listeven/SWEET/finalCode/SmartGrid/graphics/linescomplicated.png

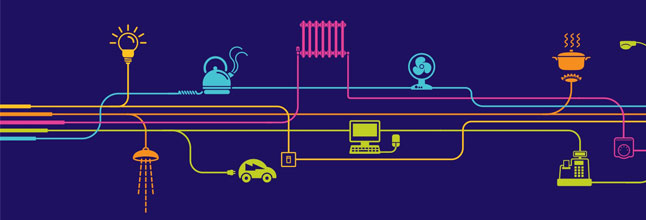
finalCode/SmartGrid/graphics/linescomplicated.png
