listeven/SWEET/Circuit PDF and CAM files/SchematicsPDF.pdf

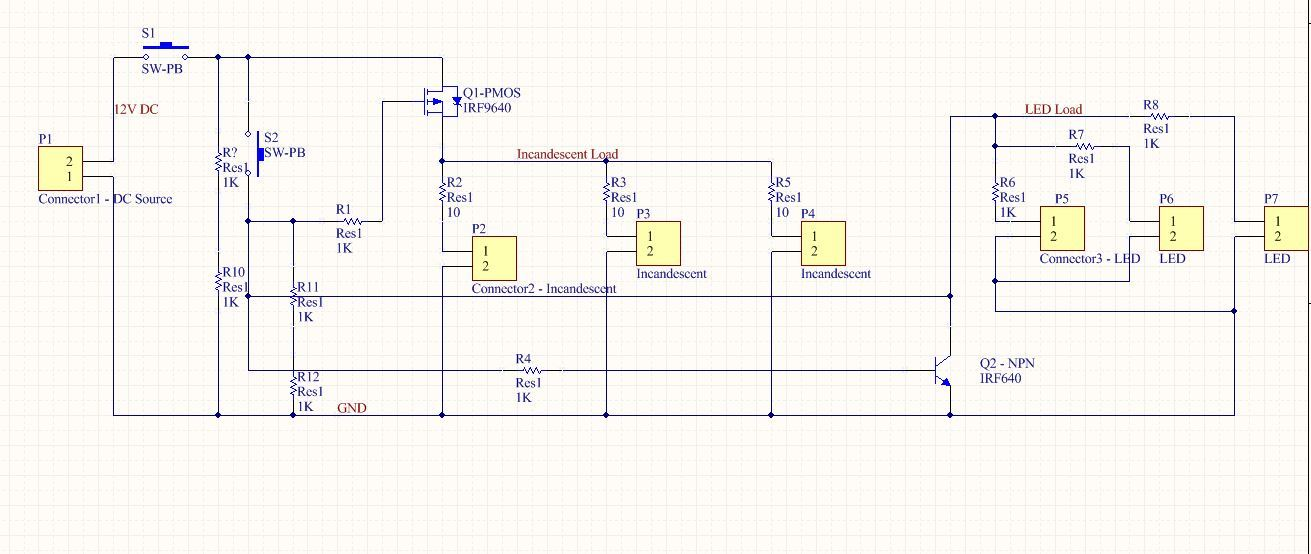
[picture p8: figure]

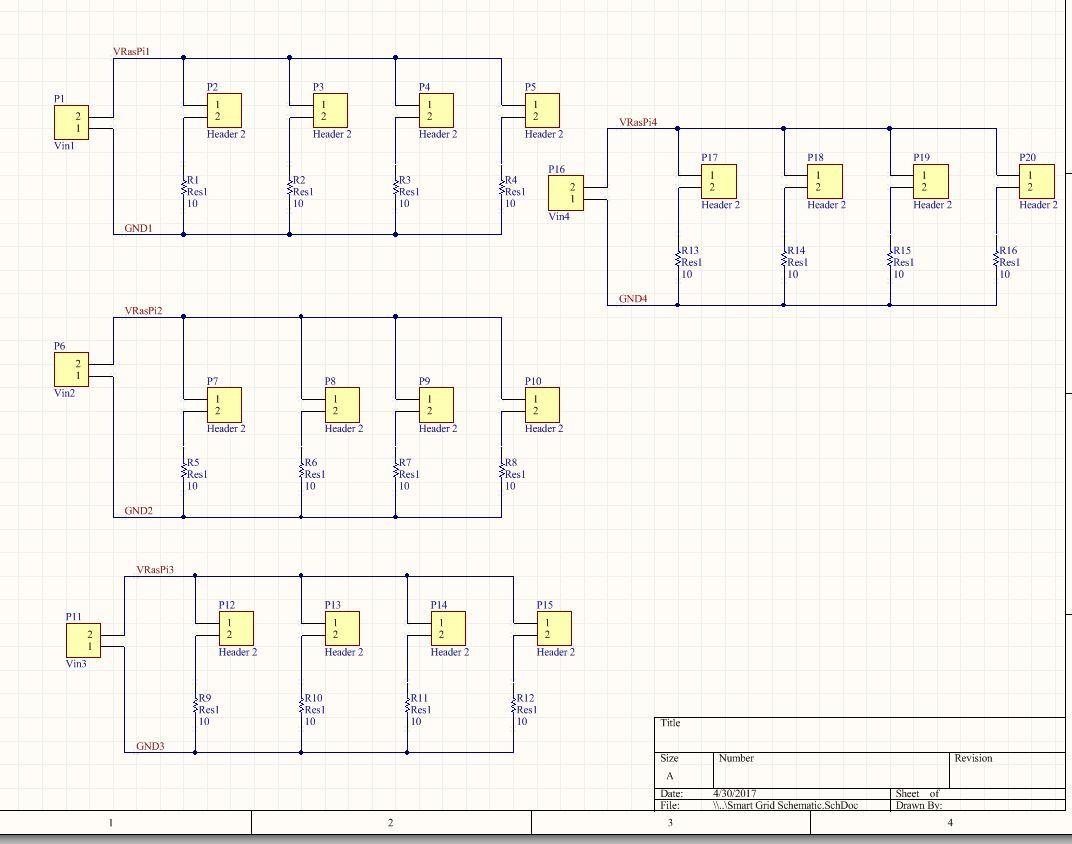
[picture p9: figure]

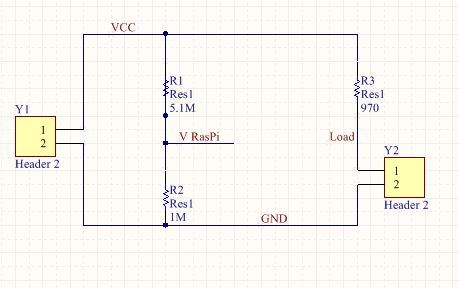
[picture p10: figure]
