listeven/SWEET/Circuit PDF and CAM files/Wind Schematic.pdf

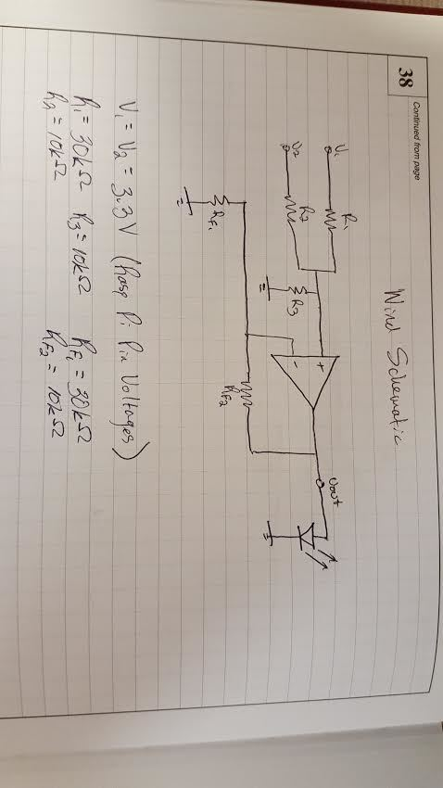
[picture p11: figure]
