listeven/SWEET/finalCode/SmartGrid/graphics/10Percent.png

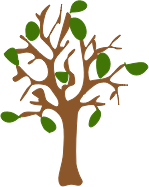
finalCode/SmartGrid/graphics/10Percent.png
