listeven/SWEET/finalCode/SmartGrid/graphics/20Percent.png

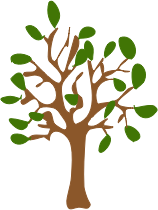
finalCode/SmartGrid/graphics/20Percent.png
