listeven/SWEET/finalCode/SmartGrid/graphics/30Percent.png

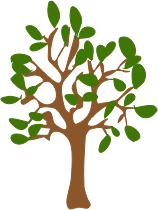
finalCode/SmartGrid/graphics/30Percent.png
