listeven/SWEET/finalCode/SmartGrid/graphics/40Percent.png

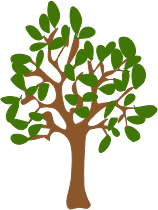
finalCode/SmartGrid/graphics/40Percent.png
