listeven/SWEET/finalCode/SmartGrid/graphics/50Percent.png

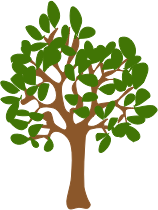
finalCode/SmartGrid/graphics/50Percent.png
