listeven/SWEET/finalCode/SmartGrid/graphics/70percent.png

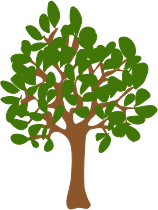
finalCode/SmartGrid/graphics/70percent.png
