listeven/SWEET/finalCode/SmartGrid/graphics/80percent.png

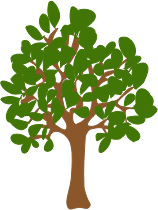
finalCode/SmartGrid/graphics/80percent.png
