listeven/SWEET/finalCode/SmartGrid/graphics/90percent.png

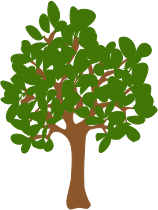
finalCode/SmartGrid/graphics/90percent.png
