listeven/SWEET/finalCode/SmartGrid/graphics/100percent.png

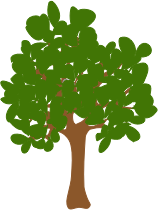
finalCode/SmartGrid/graphics/100percent.png
