listeven/SWEET/finalCode/SmartGrid/graphics/Blog_Gados_NatGrid.jpg

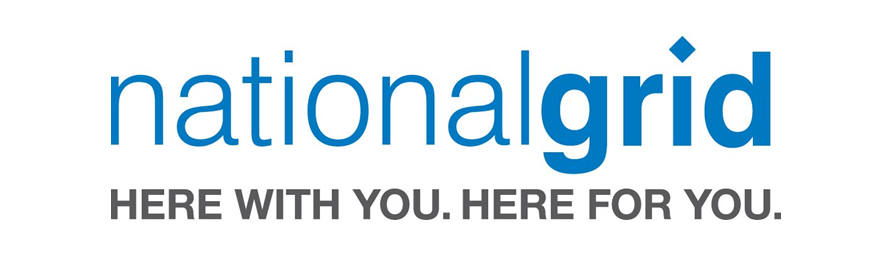
finalCode/SmartGrid/graphics/Blog_Gados_NatGrid.jpg
