listeven/SWEET/finalCode/SmartGrid/graphics/BostonSkyline.png

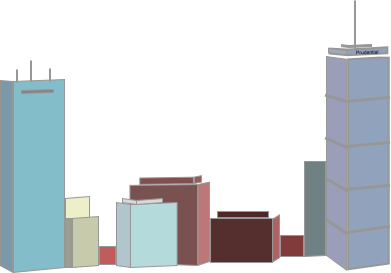
finalCode/SmartGrid/graphics/BostonSkyline.png
