listeven/SWEET/finalCode/SmartGrid/graphics/RenewableContribution.png

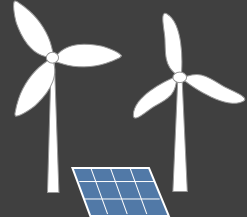
finalCode/SmartGrid/graphics/RenewableContribution.png
