listeven/SWEET/CAD Stuff/Assem2.4x10.SLDASM

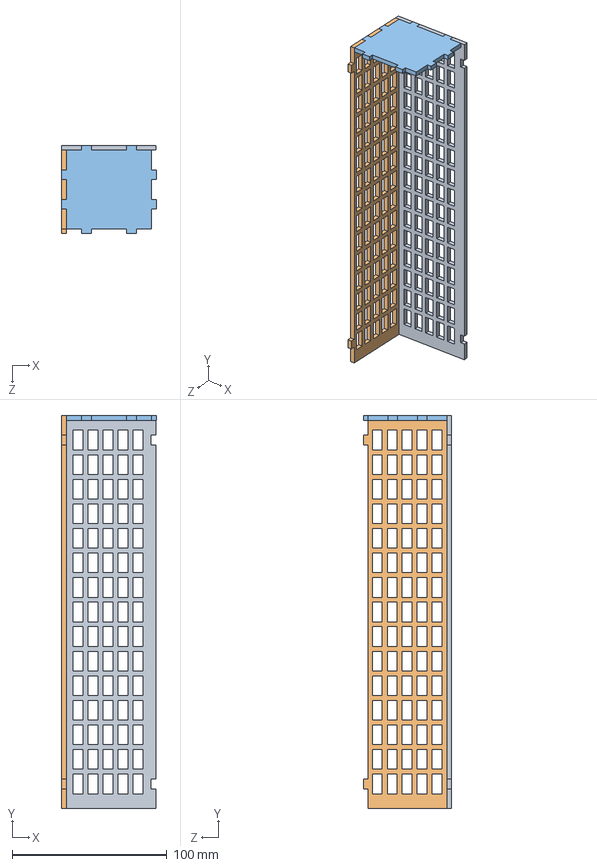
[picture p24: CAD file, 2017-05-16]
CAD Stuff/Assem2.4x10.SLDASM
61.2 x 254.0 x 57.2 mm
2.4x10_cutout
2.4x10_extensions
2.4x2.4_top
