listeven/SWEET/CAD Stuff/Assem3x7.SLDASM

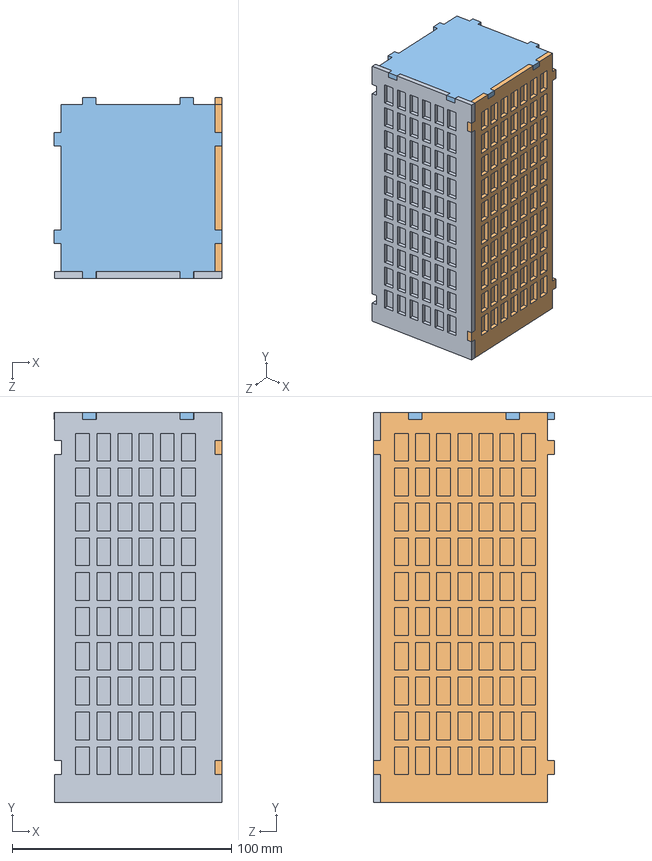
[picture p25: CAD file, 2017-05-16]
CAD Stuff/Assem3x7.SLDASM
76.5 x 177.8 x 82.5 mm
3x7_cutout
3x7_extensions
3x3_top
