listeven/SWEET/CAD Stuff/Assem4x6.SLDASM

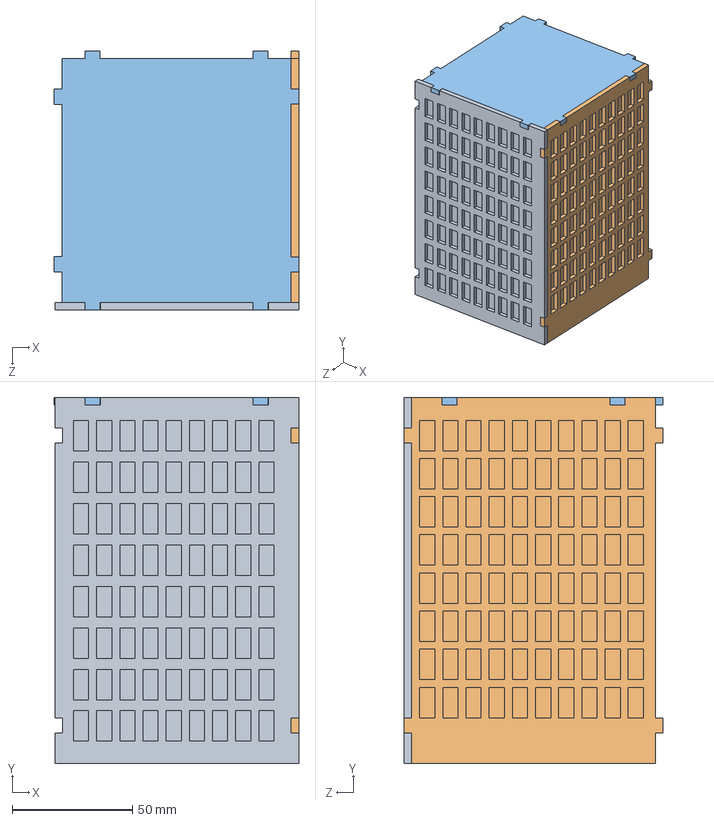
[picture p26: CAD file, 2017-05-16]
CAD Stuff/Assem4x6.SLDASM
101.9 x 152.4 x 107.9 mm
4x6cutout
4x6extensions
4x4_top
