listeven/SWEET/CAD Stuff/Assem2x6.SLDASM

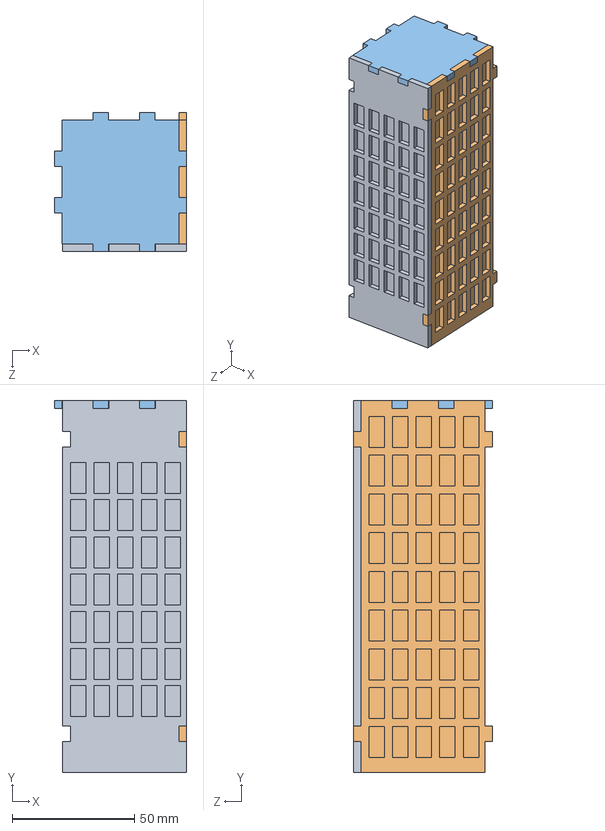
[picture p27: CAD file, 2017-05-16]
CAD Stuff/Assem2x6.SLDASM
54.1 x 152.4 x 57.2 mm
2x6_cutout
2x6_extensions
2x2_top
