listeven/SWEET/CAD Stuff/Assem2x7.SLDASM

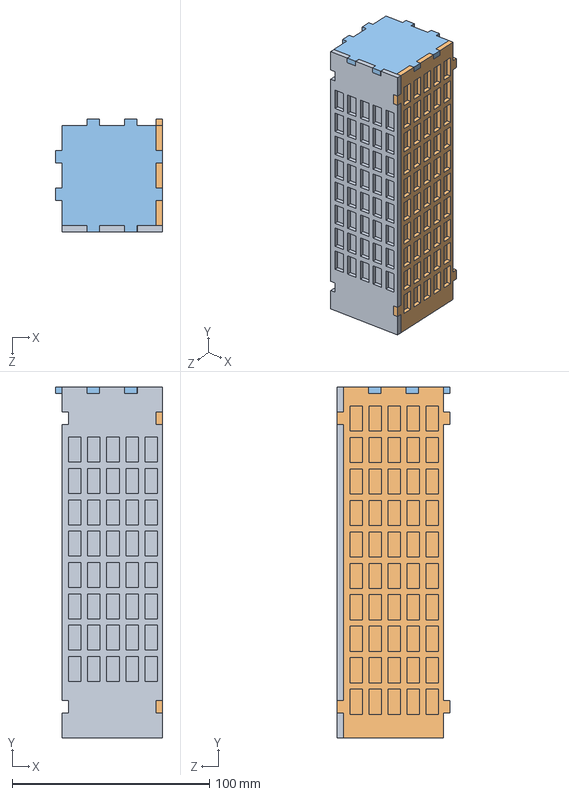
[picture p28: CAD file, 2017-05-16]
CAD Stuff/Assem2x7.SLDASM
54.1 x 177.8 x 57.2 mm
2x7_cutout
2x7_extensions
2x2_top
