listeven/SWEET/CAD Stuff/Assem3x6.SLDASM

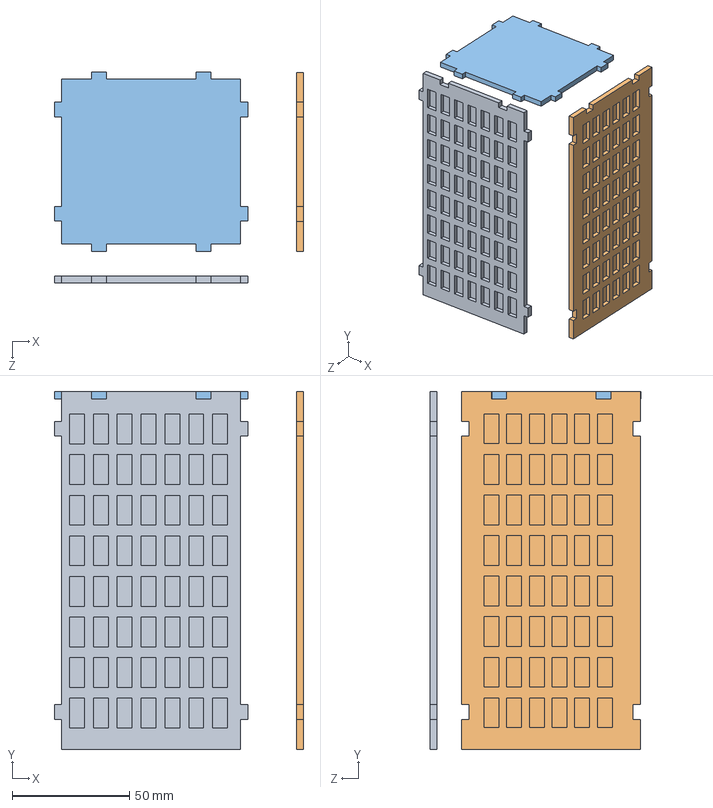
[picture p29: CAD file, 2017-05-16]
CAD Stuff/Assem3x6.SLDASM
106.2 x 152.4 x 90.0 mm
3x6_extensions
3x6_cutout
3x3_top
