listeven/SWEET/CAD Stuff/Assem2x4.SLDASM

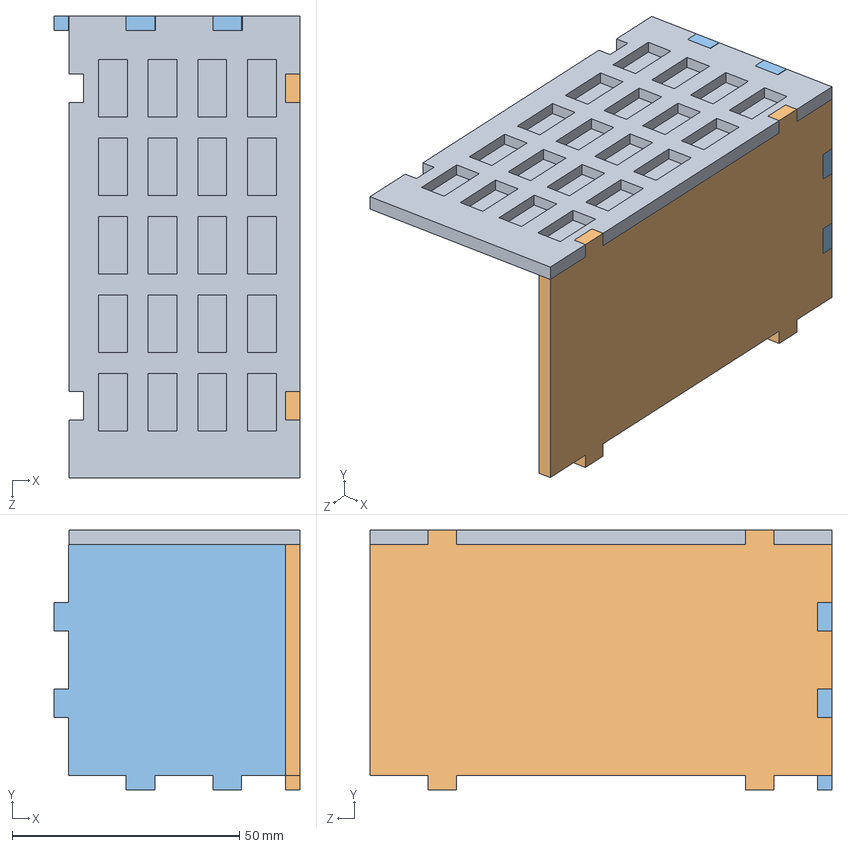
[picture p30: CAD file, 2017-05-16]
CAD Stuff/Assem2x4.SLDASM
54.1 x 57.2 x 101.6 mm
2x4_cutout
2x4_extensions
2x2_top
