listeven/SWEET/CAD Stuff/Assem2x3.SLDASM

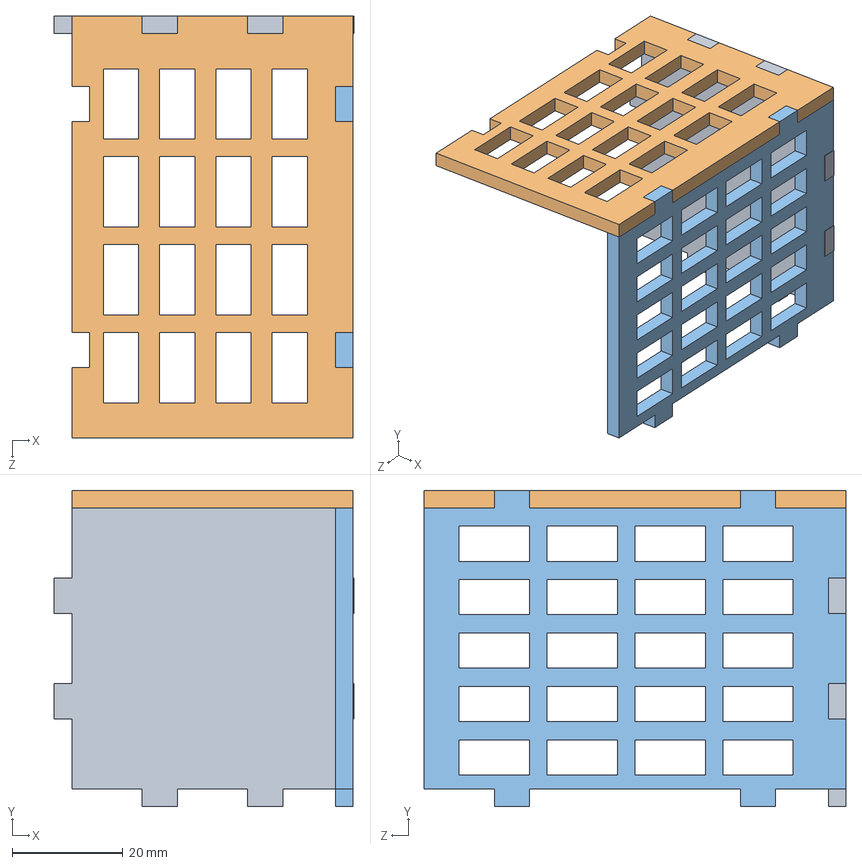
[picture p31: CAD file, 2017-05-16]
CAD Stuff/Assem2x3.SLDASM
54.1 x 57.2 x 76.2 mm
2x2_top
2x3_cutout
2x3_extensions
