listeven/SWEET/CAD Stuff/Assem3x4.SLDASM

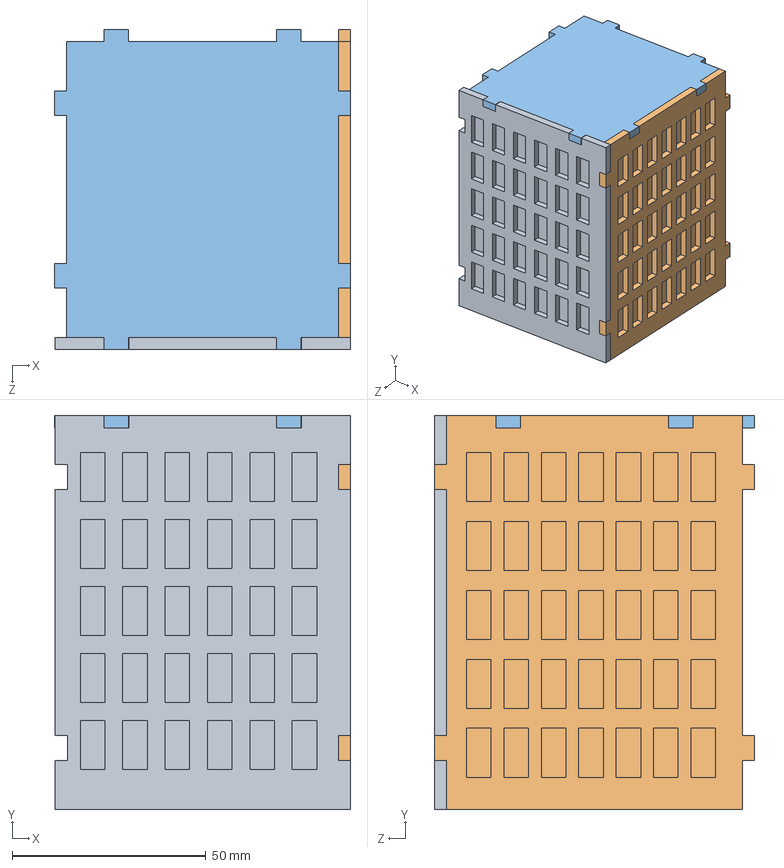
[picture p32: CAD file, 2017-05-16]
CAD Stuff/Assem3x4.SLDASM
76.5 x 101.6 x 82.5 mm
3x4_cutout
3x4_extensions
3x3_top
