listeven/SWEET/CAD Stuff/house_assembly.SLDASM

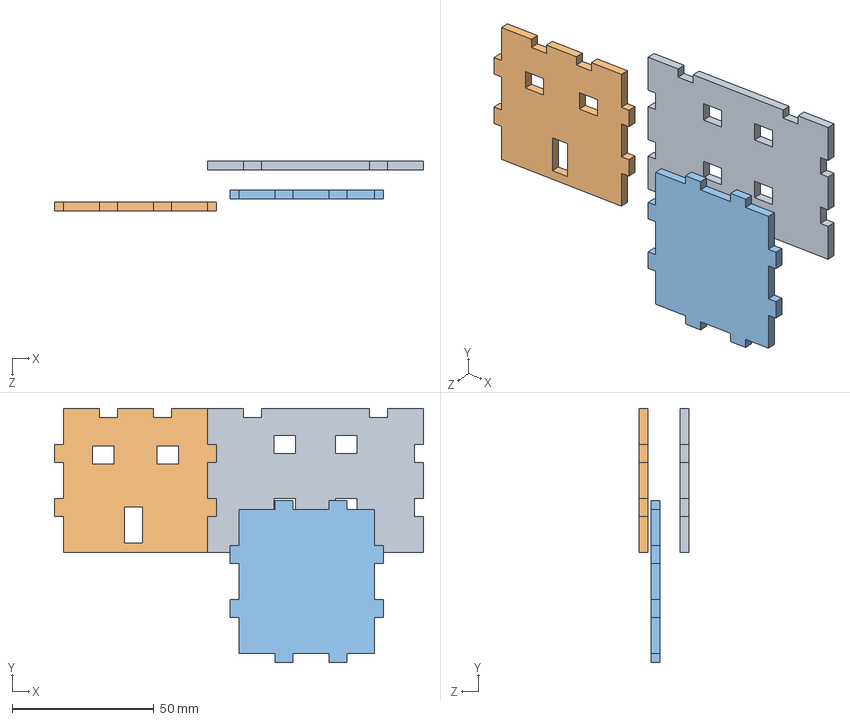
[picture p33: CAD file, 2017-05-16]
CAD Stuff/house_assembly.SLDASM
130.2 x 89.7 x 17.7 mm
house_cutout
house_extensions
house_top
