listeven/SWEET/CAD Stuff/solar.SLDASM

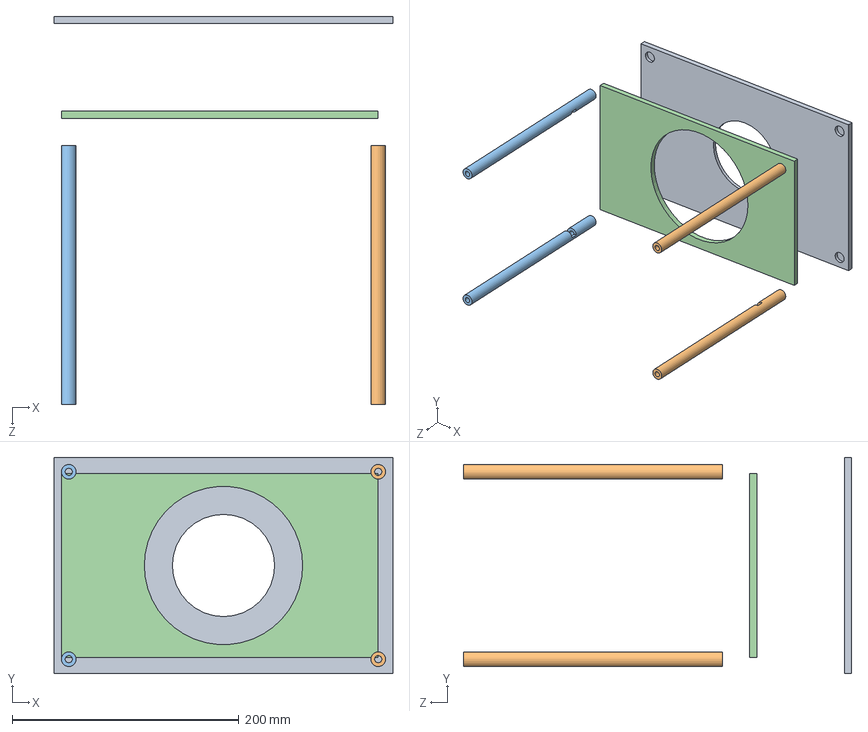
[picture p34: CAD file, 2017-05-16]
CAD Stuff/solar.SLDASM
298.7 x 191.0 x 342.4 mm
light holder
legstop x 2
leg x 2
light filter
