listeven/SWEET/CAD Stuff/2.4x10_extensions.SLDPRT

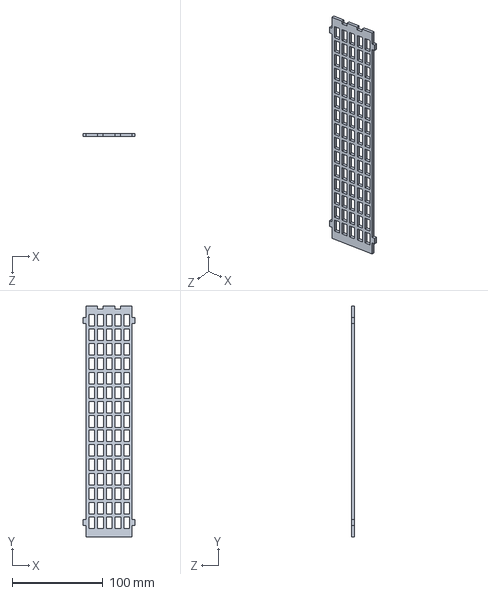
[picture p35: CAD file, 2017-05-16]
CAD Stuff/2.4x10_extensions.SLDPRT
57.2 x 254.0 x 3.17 mm
