listeven/SWEET/CAD Stuff/4x6cutout.SLDPRT

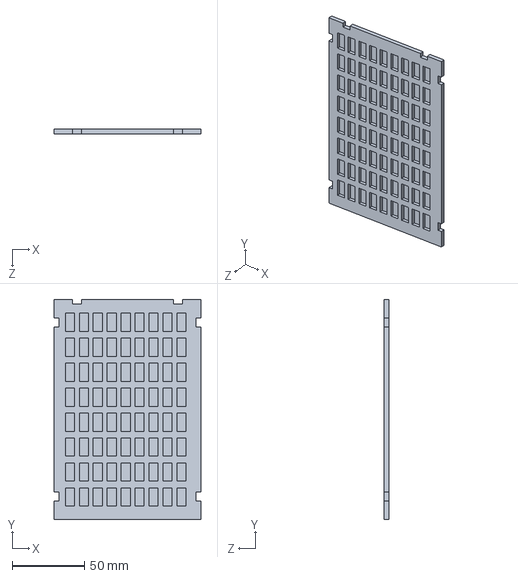
[picture p36: CAD file, 2017-05-16]
CAD Stuff/4x6cutout.SLDPRT
101.6 x 152.4 x 3.17 mm
