listeven/SWEET/CAD Stuff/3x7_extensions.SLDPRT

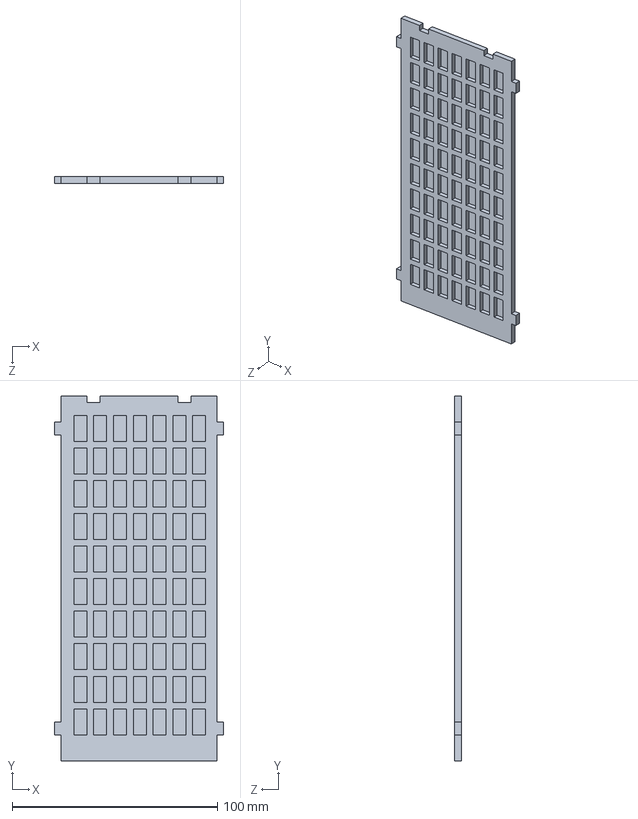
[picture p37: CAD file, 2017-05-16]
CAD Stuff/3x7_extensions.SLDPRT
82.5 x 177.8 x 3.17 mm
