listeven/SWEET/CAD Stuff/legstop.SLDPRT

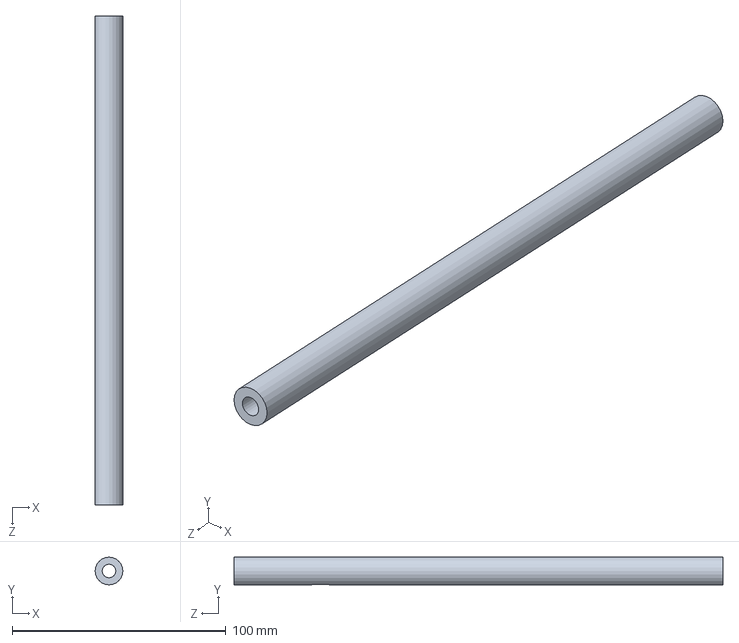
[picture p38: CAD file, 2017-05-16]
CAD Stuff/legstop.SLDPRT
13.0 x 13.0 x 228.6 mm
