listeven/SWEET/CAD Stuff/3x3_top.SLDPRT

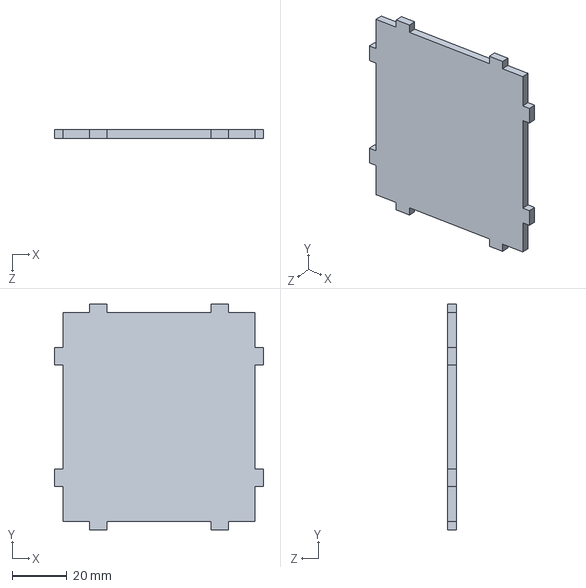
[picture p39: CAD file, 2017-05-16]
CAD Stuff/3x3_top.SLDPRT
76.5 x 82.5 x 3.17 mm
