listeven/SWEET/CAD Stuff/2.4x10_cutout.SLDPRT

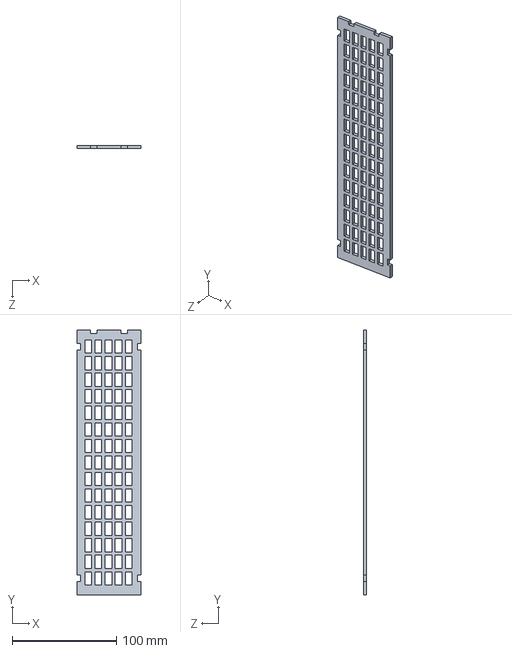
[picture p40: CAD file, 2017-05-16]
CAD Stuff/2.4x10_cutout.SLDPRT
61.0 x 254.0 x 3.17 mm
