listeven/SWEET/CAD Stuff/2x3_cutout.SLDPRT

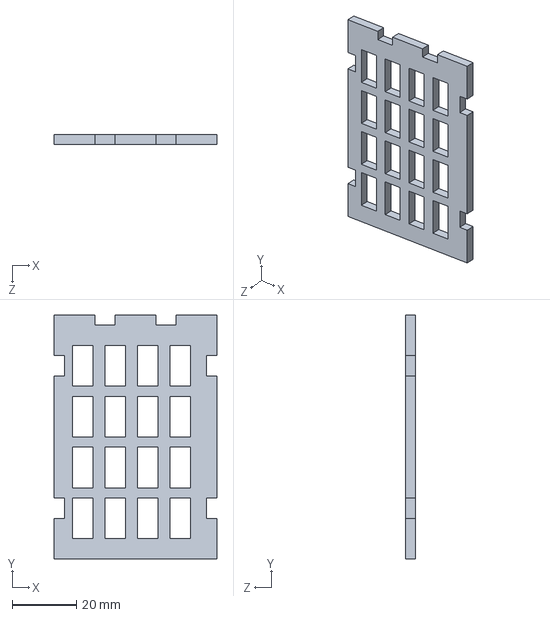
[picture p41: CAD file, 2017-05-16]
CAD Stuff/2x3_cutout.SLDPRT
50.8 x 76.2 x 3.17 mm
