listeven/SWEET/CAD Stuff/3x4_cutout.SLDPRT

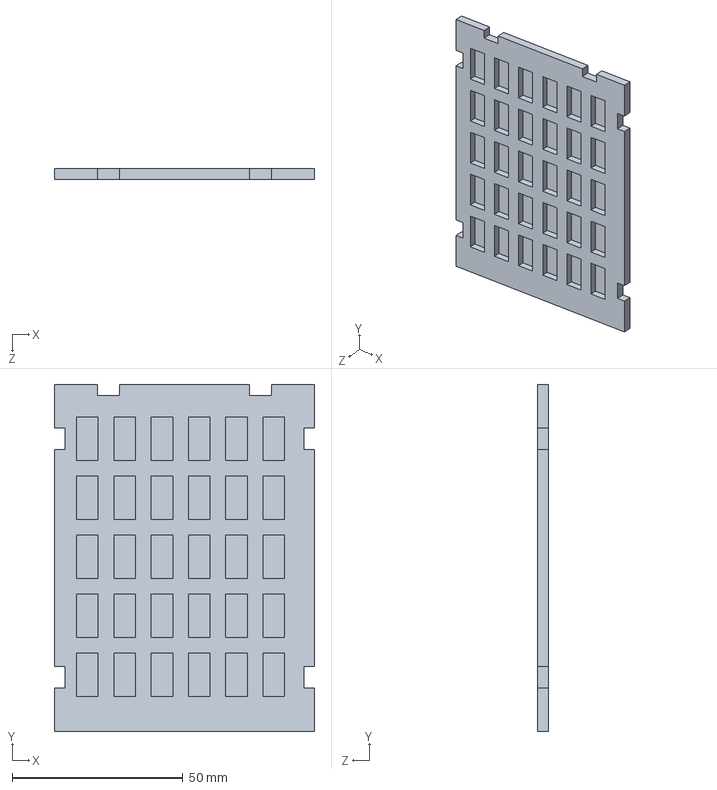
[picture p42: CAD file, 2017-05-16]
CAD Stuff/3x4_cutout.SLDPRT
76.2 x 101.6 x 3.17 mm
