listeven/SWEET/CAD Stuff/2x7_extensions.SLDPRT

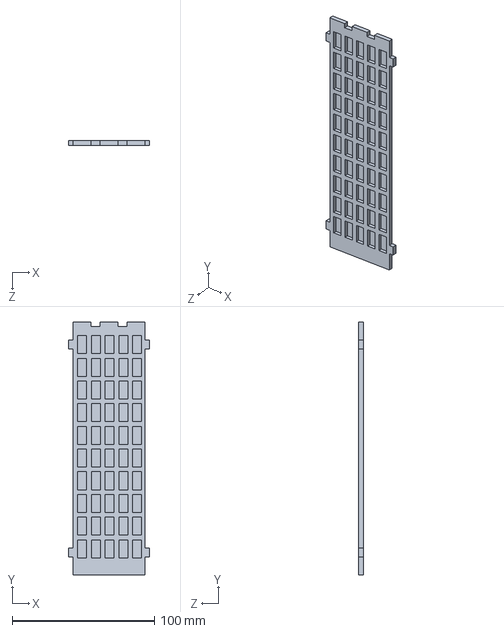
[picture p43: CAD file, 2017-05-16]
CAD Stuff/2x7_extensions.SLDPRT
57.2 x 177.8 x 3.17 mm
