listeven/SWEET/CAD Stuff/light holder.SLDPRT

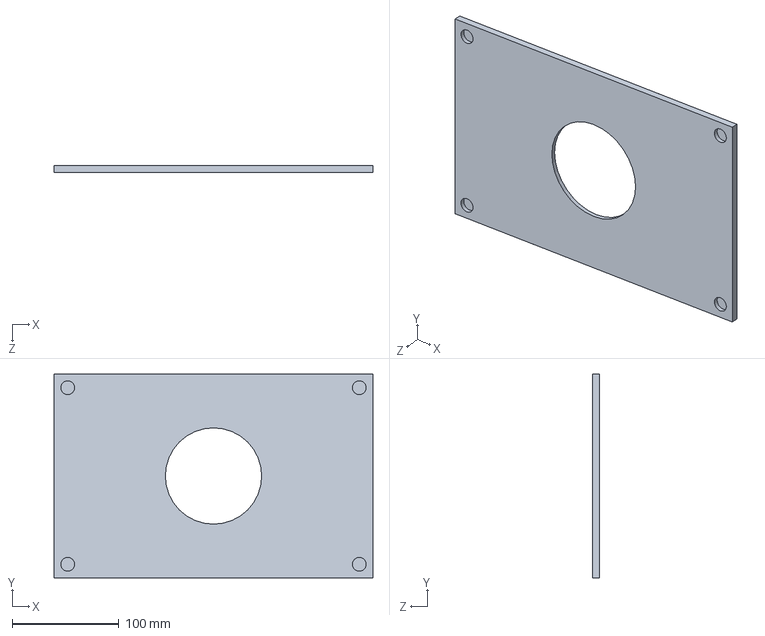
[picture p44: CAD file, 2017-05-16]
CAD Stuff/light holder.SLDPRT
298.7 x 191.0 x 6.35 mm
