listeven/SWEET/CAD Stuff/2.4x2.4_top.SLDPRT

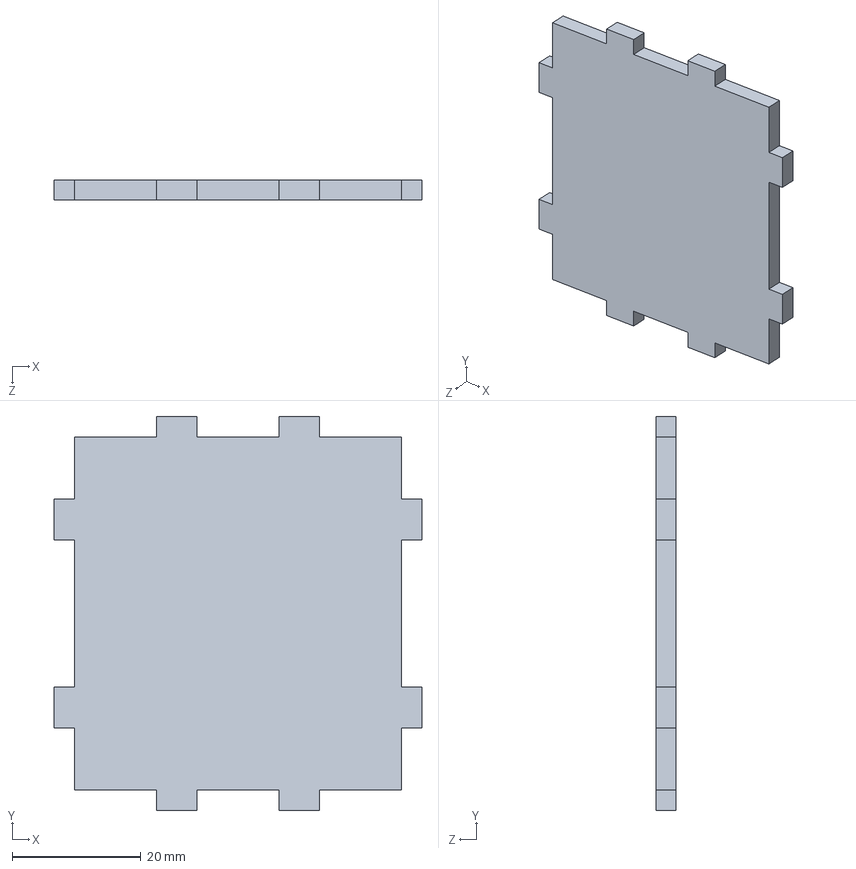
[picture p45: CAD file, 2017-05-16]
CAD Stuff/2.4x2.4_top.SLDPRT
57.2 x 61.2 x 3.17 mm
