listeven/SWEET/CAD Stuff/2x6_extensions.SLDPRT

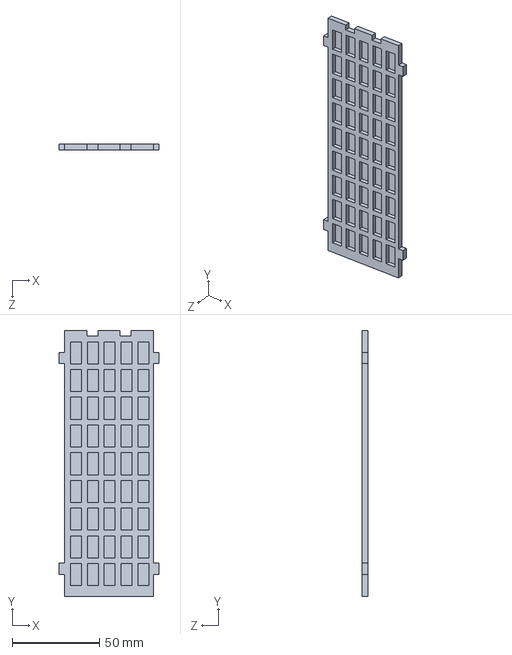
[picture p46: CAD file, 2017-05-16]
CAD Stuff/2x6_extensions.SLDPRT
57.2 x 152.4 x 3.17 mm
