listeven/SWEET/CAD Stuff/3x4_extensions.SLDPRT

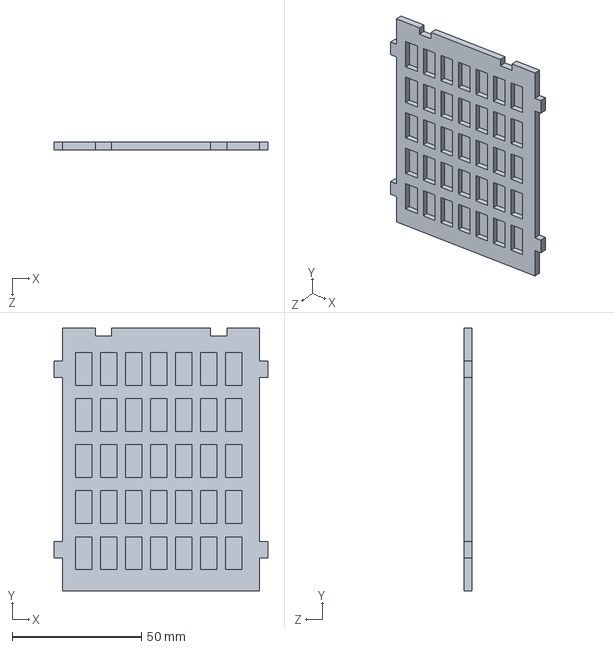
[picture p47: CAD file, 2017-05-16]
CAD Stuff/3x4_extensions.SLDPRT
82.5 x 101.6 x 3.17 mm
