listeven/SWEET/CAD Stuff/3x7_cutout.SLDPRT

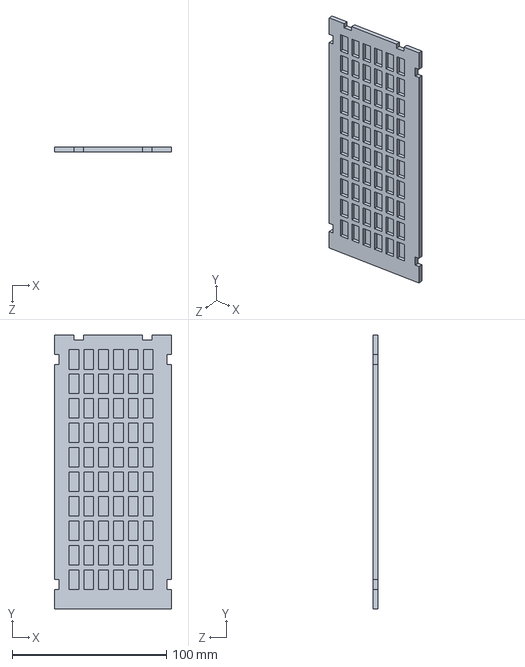
[picture p48: CAD file, 2017-05-16]
CAD Stuff/3x7_cutout.SLDPRT
76.2 x 177.8 x 3.17 mm
