listeven/SWEET/CAD Stuff/light filter.SLDPRT

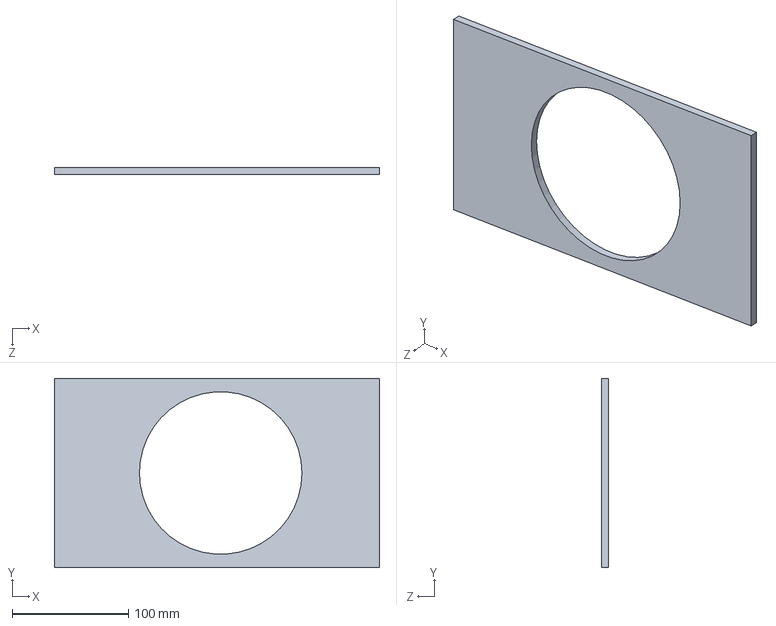
[picture p49: CAD file, 2017-05-16]
CAD Stuff/light filter.SLDPRT
279.4 x 162.6 x 6.35 mm
