listeven/SWEET/CAD Stuff/2x2_top.SLDPRT

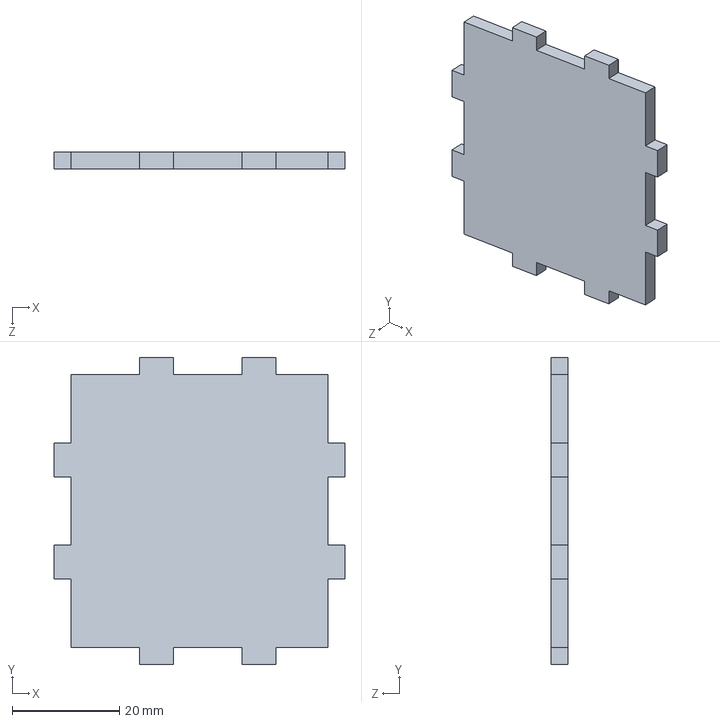
[picture p50: CAD file, 2017-05-16]
CAD Stuff/2x2_top.SLDPRT
54.1 x 57.2 x 3.17 mm
