listeven/SWEET/CAD Stuff/2x4_extensions.SLDPRT

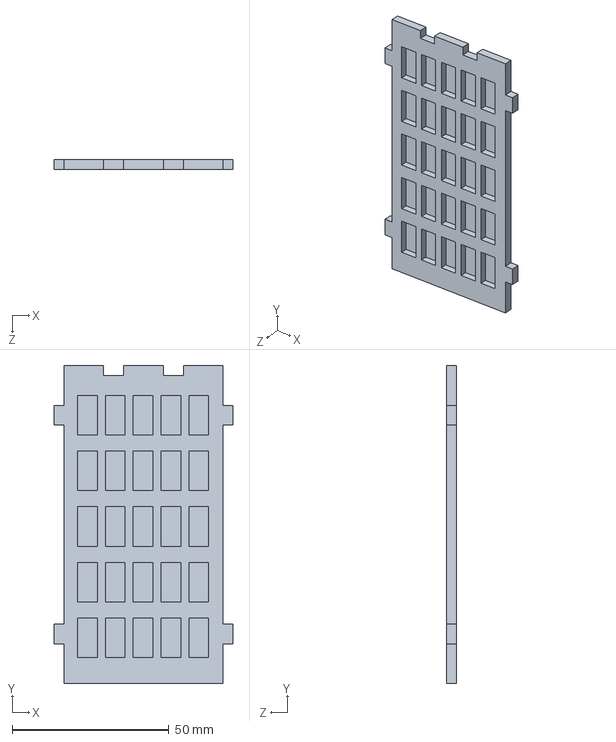
[picture p51: CAD file, 2017-05-16]
CAD Stuff/2x4_extensions.SLDPRT
57.2 x 101.6 x 3.17 mm
