listeven/SWEET/CAD Stuff/2x7_cutout.SLDPRT

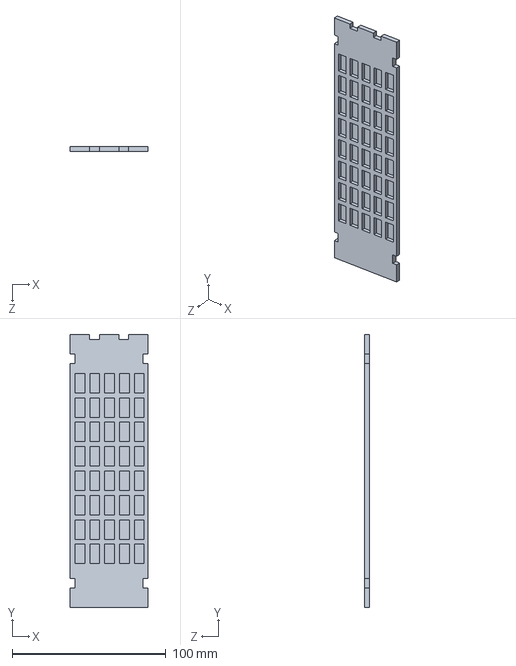
[picture p52: CAD file, 2017-05-16]
CAD Stuff/2x7_cutout.SLDPRT
50.8 x 177.8 x 3.17 mm
