listeven/SWEET/CAD Stuff/2x3_extensions.SLDPRT

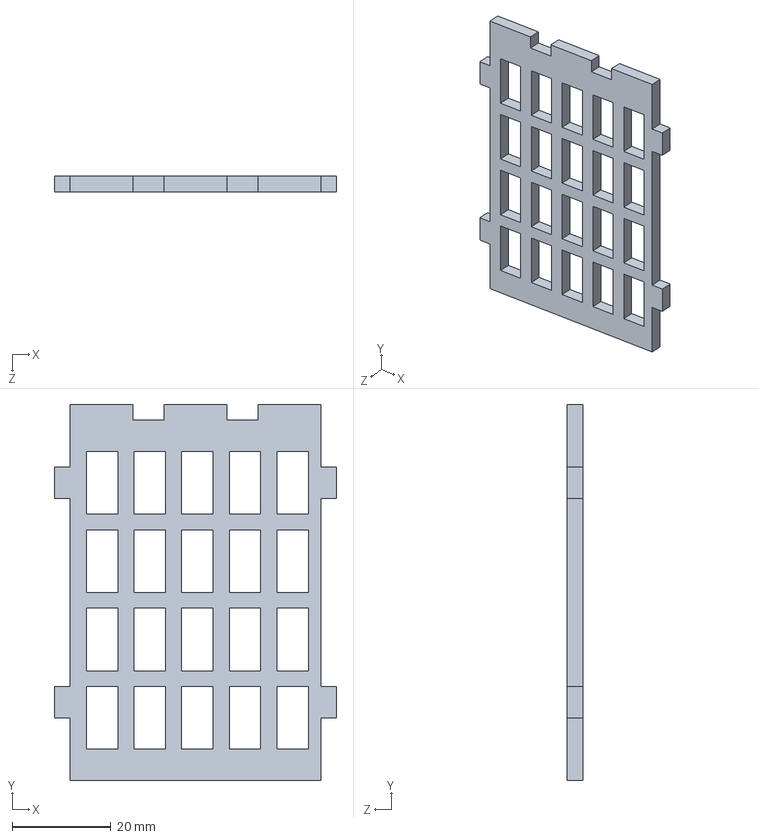
[picture p53: CAD file, 2017-05-16]
CAD Stuff/2x3_extensions.SLDPRT
57.2 x 76.2 x 3.17 mm
