listeven/SWEET/CAD Stuff/3x6_cutout.SLDPRT

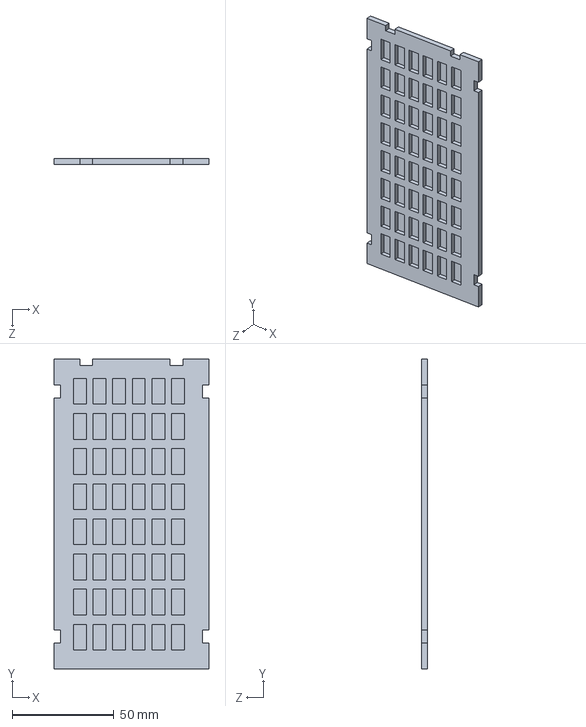
[picture p54: CAD file, 2017-05-16]
CAD Stuff/3x6_cutout.SLDPRT
76.2 x 152.4 x 3.17 mm
