listeven/SWEET/CAD Stuff/2x6_cutout.SLDPRT

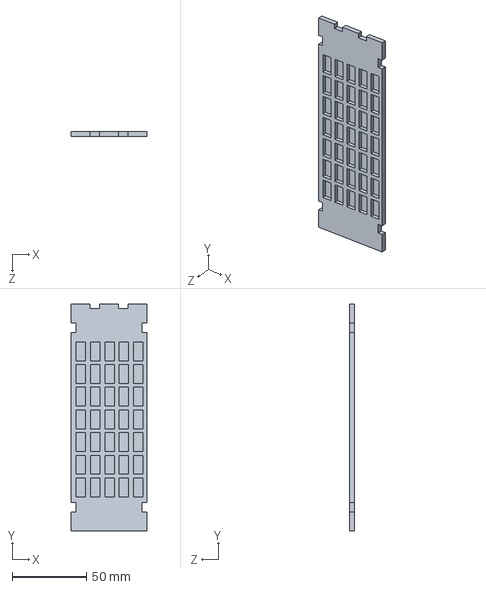
[picture p55: CAD file, 2017-05-16]
CAD Stuff/2x6_cutout.SLDPRT
50.8 x 152.4 x 3.17 mm
