listeven/SWEET/CAD Stuff/3x6_extensions.SLDPRT

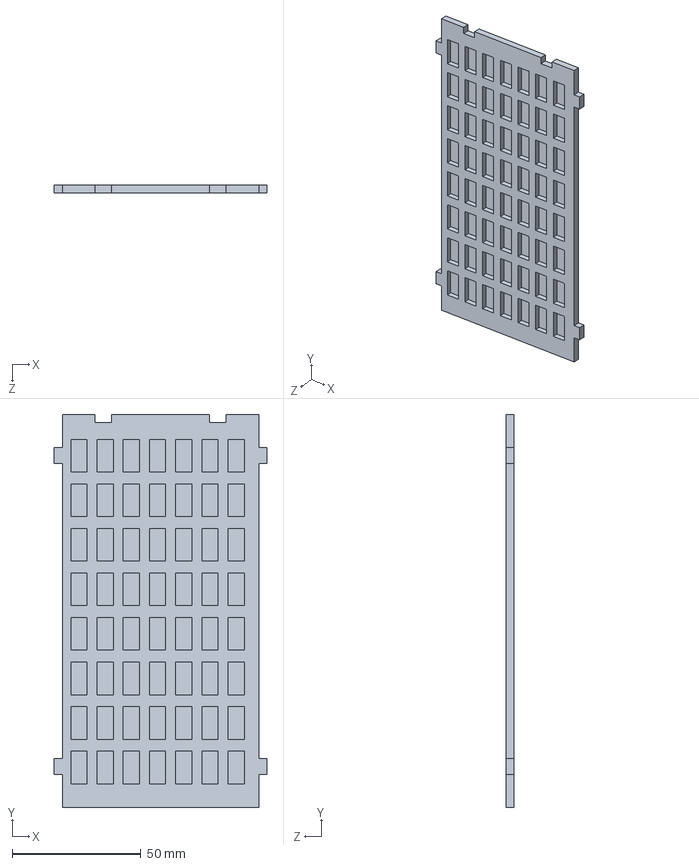
[picture p56: CAD file, 2017-05-16]
CAD Stuff/3x6_extensions.SLDPRT
82.5 x 152.4 x 3.17 mm
