listeven/SWEET/CAD Stuff/2x4_cutout.SLDPRT

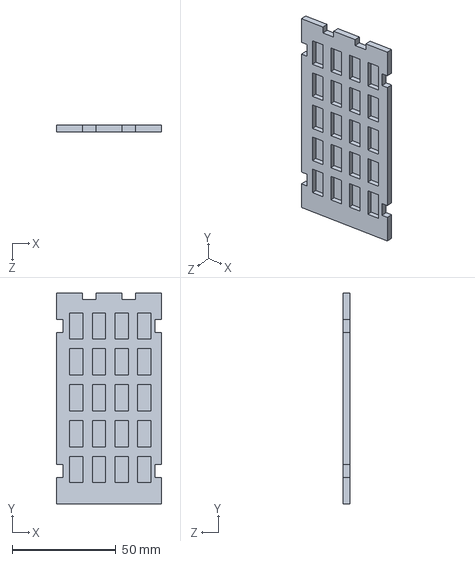
[picture p57: CAD file, 2017-05-16]
CAD Stuff/2x4_cutout.SLDPRT
50.8 x 101.6 x 3.17 mm
