listeven/SWEET/CAD Stuff/4x4_top.SLDPRT

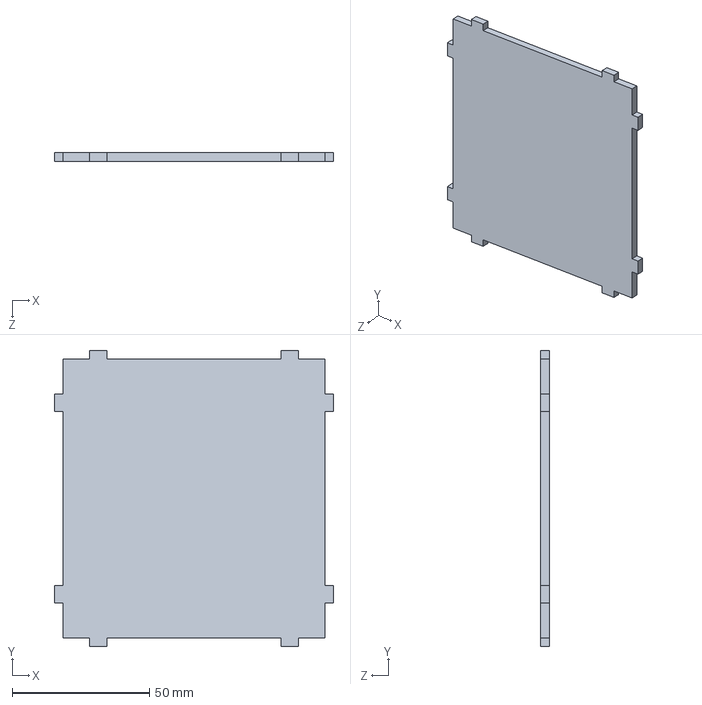
[picture p58: CAD file, 2017-05-16]
CAD Stuff/4x4_top.SLDPRT
101.9 x 107.9 x 3.17 mm
