listeven/SWEET/CAD Stuff/4x6extensions.SLDPRT

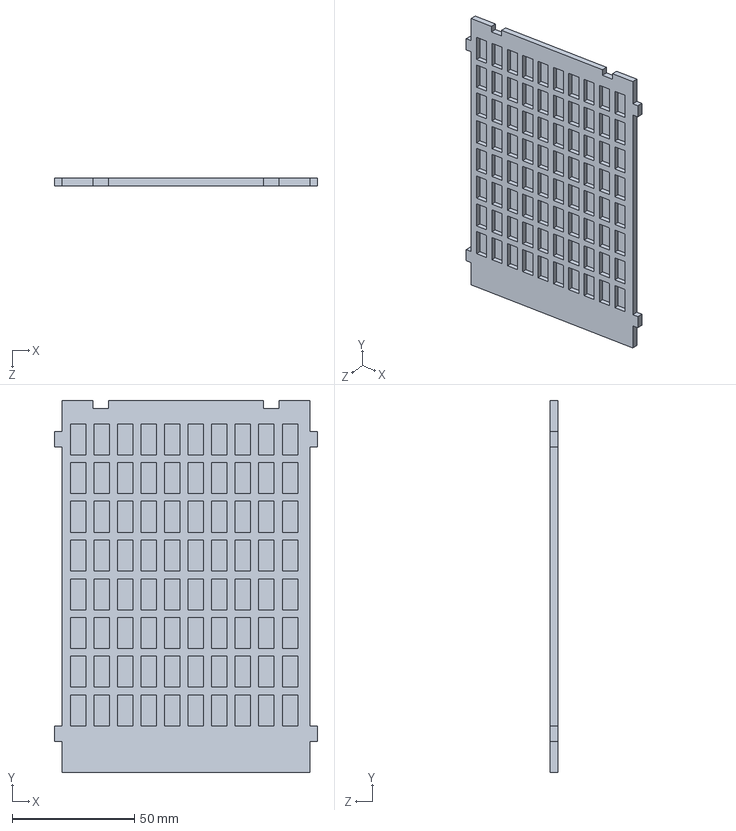
[picture p59: CAD file, 2017-05-16]
CAD Stuff/4x6extensions.SLDPRT
107.9 x 152.4 x 3.17 mm
