listeven/SWEET/(list of files, cad)

Other CAD files:
CAD Stuff/leg.SLDPRT
