listeven/SWEET/CAD Stuff/pdfs/buildings/Assem2.4x10.PDF

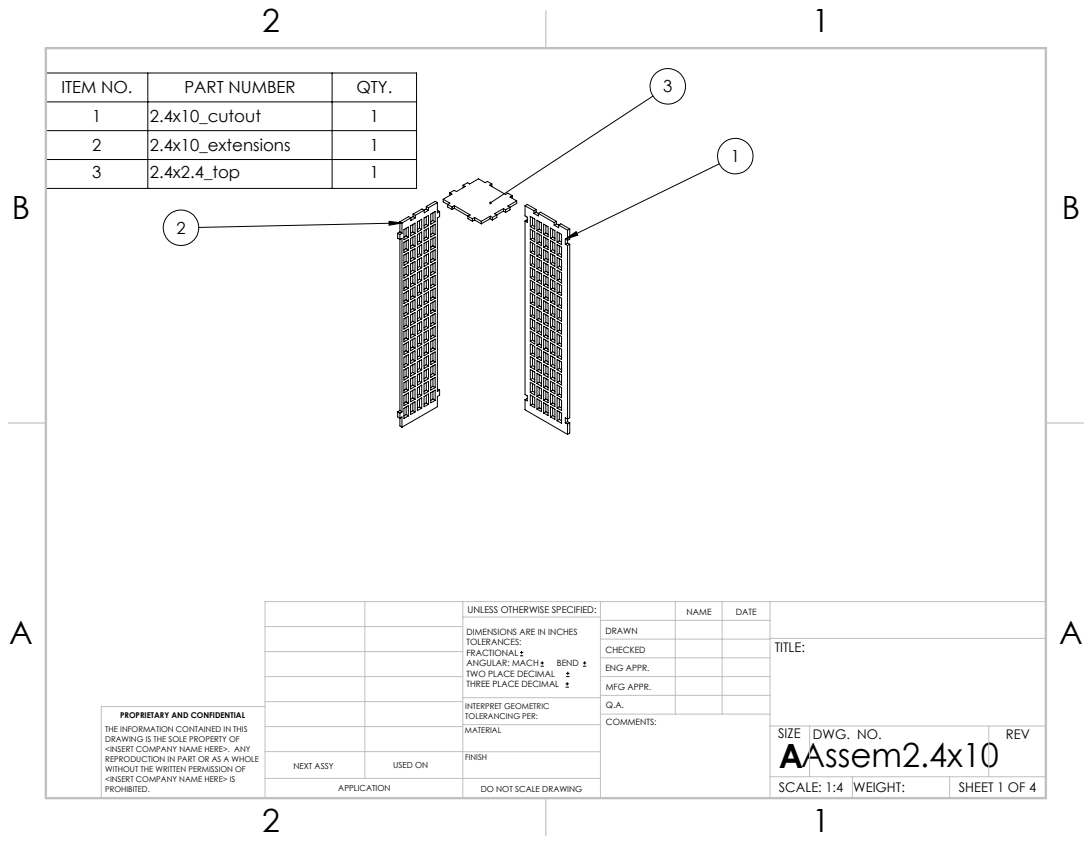
[picture p79: page 1]

ITEM NO. | PART NUMBER | QTY.
1 | 2.4x10_cutout | 1
2 | 2.4x10_extensions | 1
3 | 2.4x2.4_top | 1

UNLESS OTHERWISE SPECIFIED: | | NAME | DATE
DIMENSIONS ARE IN INCHES TOLERANCES: FRACTIONAL ANGULAR: MACH BEND TWO PLACE DECIMAL THREE PLACE DECIMAL | DRAWN

CHECKED | | | TITLE:

ENG APPR.
MFG APPR.

INTERPRET GEOMETRIC TOLERANCING PER: | Q.A.
MATERIAL | | SIZE A Assem2.4x10 | DWG. NO. | REV

PROPRIETARY AND CONFIDENTIAL
THE INFORMATION CONTAINED IN THIS
DRAWING IS THE SOLE PROPERTY OF
<INSERT COMPANY NAME HERE>. ANY
REPRODUCTION IN PART OR AS A WHOLE
WITHOUT THE WRITTEN PERMISSION OF
<INSERT COMPANY NAME HERE> IS
PROHIBITED.

NEXT ASSY | USED ON | FINISH

APPLICATION | DO NOT SCALE DRAWING | | SCALE: 1:4 | WEIGHT: | SHEET 1 OF 4

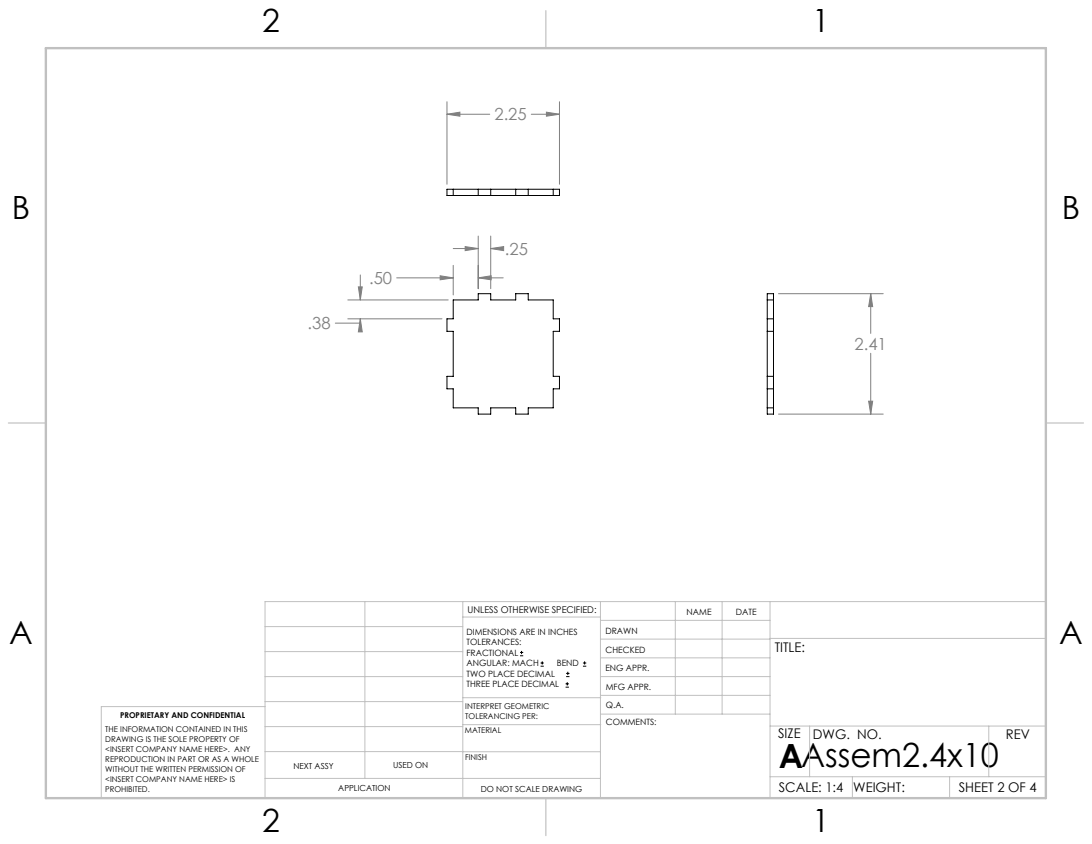
[picture p80: page 2]
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

CHECKED | | | TITLE:

ENG APPR.
MFG APPR.

INTERPRET GEOMETRIC TOLERANCING PER: | Q.A.
MATERIAL | | SIZE A Assem2.4x10 | DWG. NO. | REV

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

NEXT ASSY | USED ON | FINISH

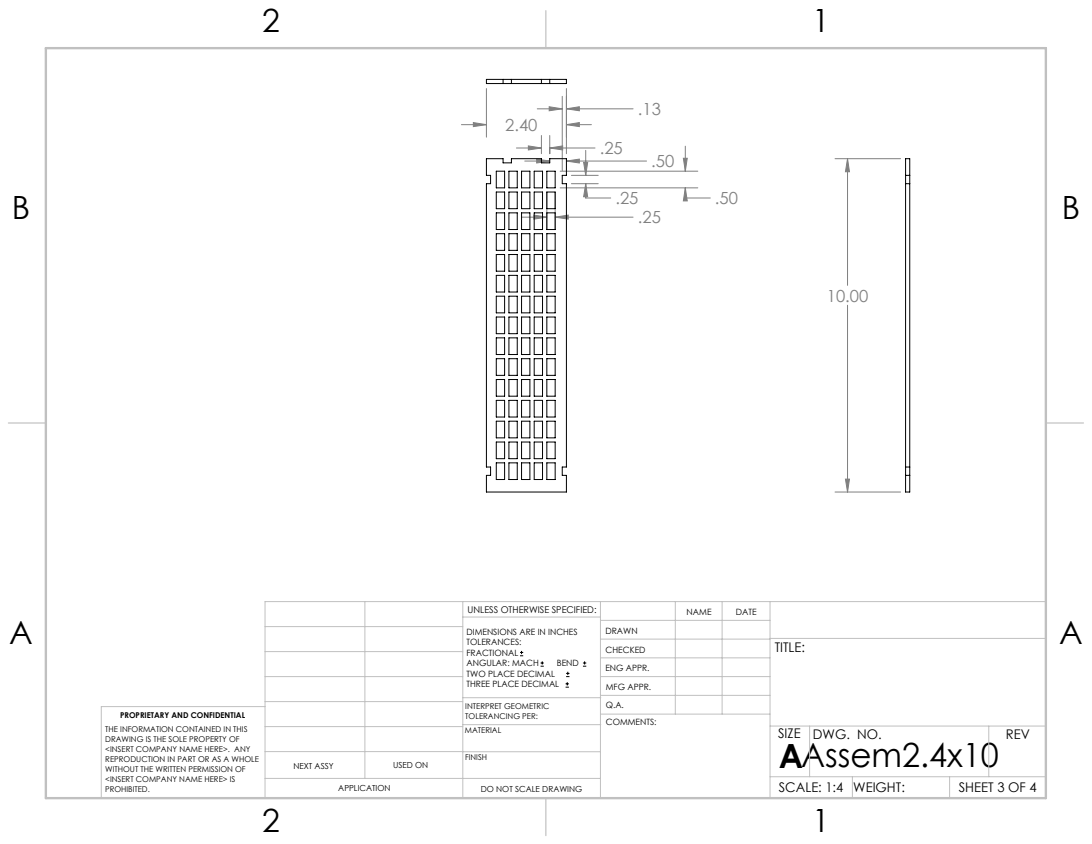
[picture p81: page 3]
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

CHECKED | | | TITLE:

ENG APPR.
MFG APPR.

INTERPRET GEOMETRIC TOLERANCING PER: | Q.A.
MATERIAL | | SIZE A Assem2.4x10 | DWG. NO. | REV

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

NEXT ASSY | USED ON | FINISH

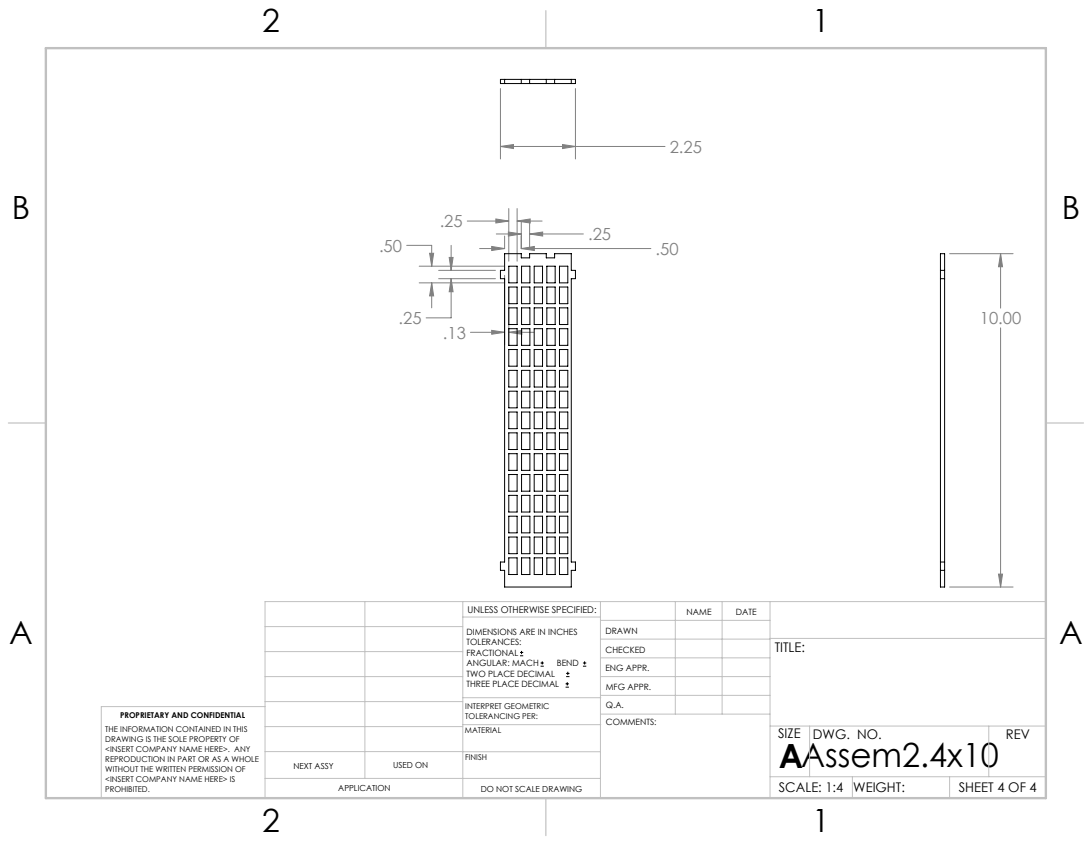
[picture p82: page 4]
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

CHECKED | | | TITLE:

ENG APPR.
MFG APPR.

INTERPRET GEOMETRIC TOLERANCING PER: | Q.A.
MATERIAL | | SIZE A Assem2.4x10 | DWG. NO. | REV

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

NEXT ASSY | USED ON | FINISH
