listeven/SWEET/(list of files, drawings)

Other design files:
Circuit PDF and CAM files/PCB - EE.PcbDoc
Circuit PDF and CAM files/PCB - Solar.PcbDoc
Circuit PDF and CAM files/Smart Grid PCB.PcbDoc
Circuit PDF and CAM files/Smart Grid Schematic.SchDoc
Circuit PDF and CAM files/Smart Grid.PrjPcb
Circuit PDF and CAM files/Solar Schematic.SchDoc
Circuit PDF and CAM files/Solar.PrjPcb
